dominicstange13/The-Infinite-Book/booklayout.jpeg

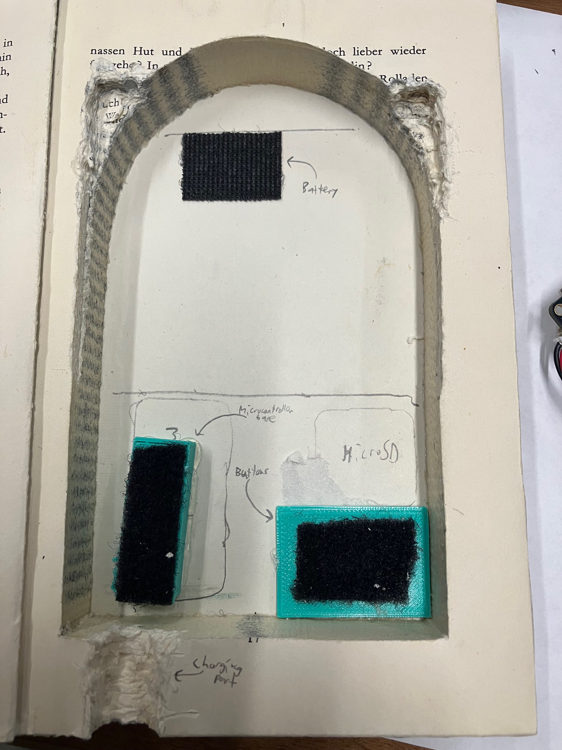
booklayout.jpeg
