dominicstange13/The-Infinite-Book/BOM.csv

Item Name | Qty | Price (total) (USD) | Item link | Notes
4.2" E-paper display | 1 | $24.95 | https://www.adafruit.com/product/6381
3.7v 500mAh LiPo Battery | 1 | $7.95 | https://www.adafruit.com/product/1578
Adafruit RP2040 Feather ThinkInk | 1 | $17.50 | https://www.adafruit.com/product/5727
Adafruit MicroSD SPI or SDIO Breakout Board | 1 | $3.50 | https://www.adafruit.com/product/4682
Copper Wire | 1 | $13.98 | https://www.amazon.com/BNTECHGO-Silicone-Flexible-Stranded-Impedance/dp/B01KCPKSEK?s=industrial | Literally almost any wire will work for this, don't worry!
2 pin push buttons | 3 | $7.49 | https://www.walmart.com/ip/44pcs-6x3-5x5mm-Round-Pushbutton-2-Pin-Momentary-DIP-Tactile-Switch/45588157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 | Only about 17 cents each
PLA filament | 1 | $14.97 | https://www.3djake.com/the-filament/pla-circuit-green | The cost of the parts themselves to print is basically nothing
Adhesive velcro strips | 1 | $2.49 | https://www.corpconnect.com/self-adhesive-velcro-strip-3 | The velcro goes on top of the microcontroller base, beneath the battery and beneath the buttons
MicroSD card (16gb) | 1 | $10.00 | https://www.walmart.com/ip/Team-16GB-microSDHC-UHS-I-U1-Class-10-Memory-Card-with-Adapter-Speed-Up-to-80MB-s-TUSDH16GCL10U03/5005423566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 | 16gb is honestly overkill, you can use less and you'll probably be fine as plain text takes up very little space
Book safe | 1 | $18.48 | https://www.etsy.com/listing/633148006/blue-hollow-book-safe-book-safe-hollowed?gpla=1&gao=1&=
1kohm resistors | 2 | $1.25 | https://www.sparkfun.com/resistor-1k-ohm-1-4-watt-pth-20-pack-thick-leads.html | Only a few cents each
Arduino libraries | N/A | N/A | N/A | SD, Adafruit BusIO, Adafruit EPD, Adafruit GFX Library, GxEPD2
Total Price (USD): | $122.56
