dominicstange13/The-Infinite-Book/CAD files/microcontroller base.step

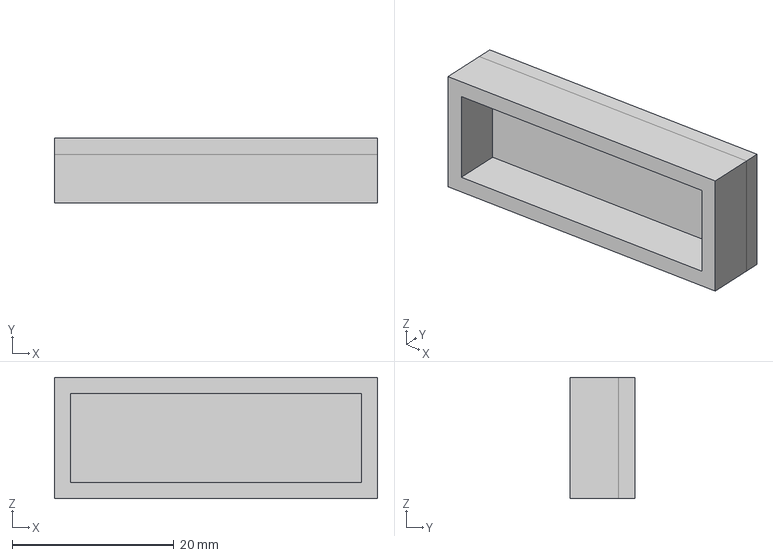
[picture p3: CAD file, 2026-10-19]
CAD files/microcontroller base.step
40.0 x 8.00 x 15.0 mm
