dominicstange13/The-Infinite-Book/CAD files/button rear.step

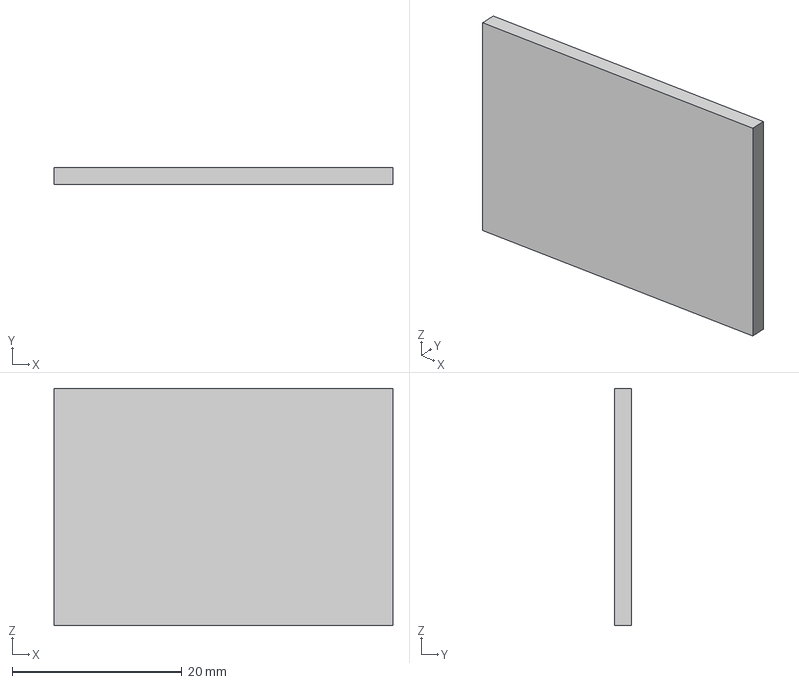
[picture p4: CAD file, 2026-10-19]
CAD files/button rear.step
40.0 x 2.00 x 28.0 mm
