dominicstange13/The-Infinite-Book/CAD files/button panel.step

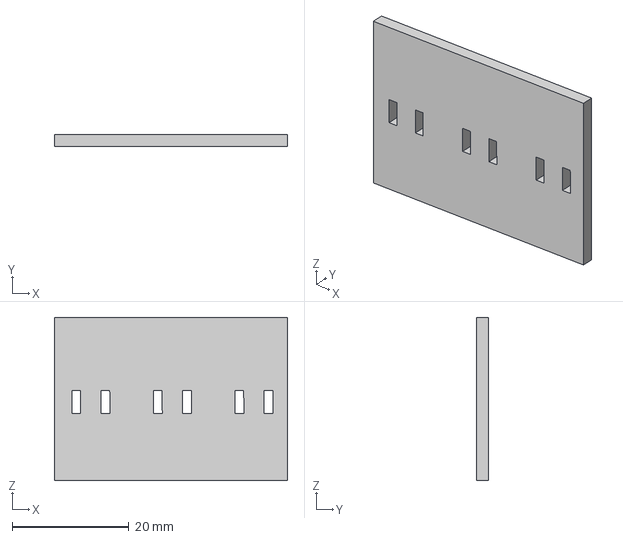
[picture p5: CAD file, 2026-10-19]
CAD files/button panel.step
40.0 x 2.00 x 28.0 mm
