dominicstange13/The-Infinite-Book/wiring/wiring1.jpeg

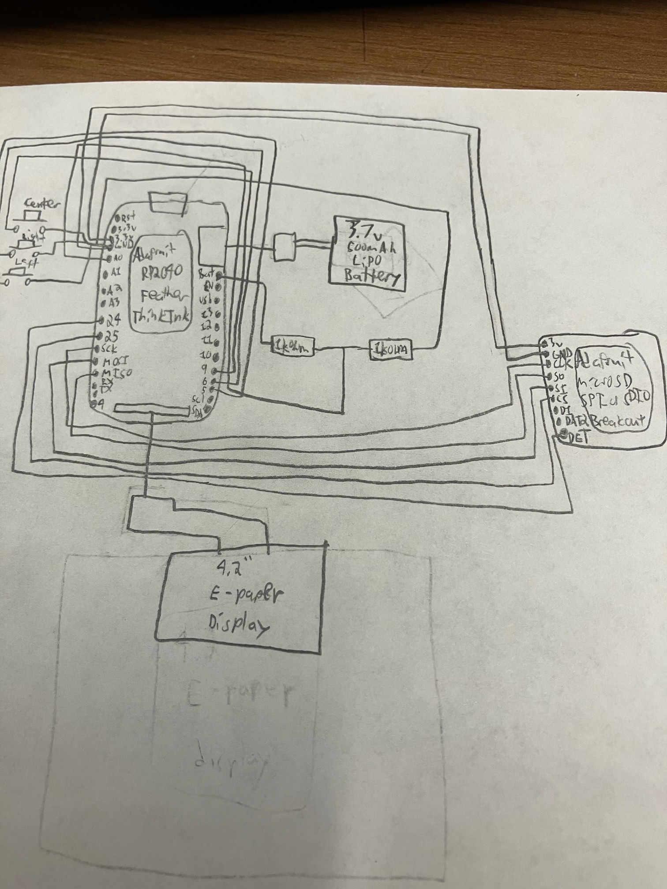
wiring/wiring1.jpeg
