dominicstange13/The-Infinite-Book/wiring/wiring2.jpeg

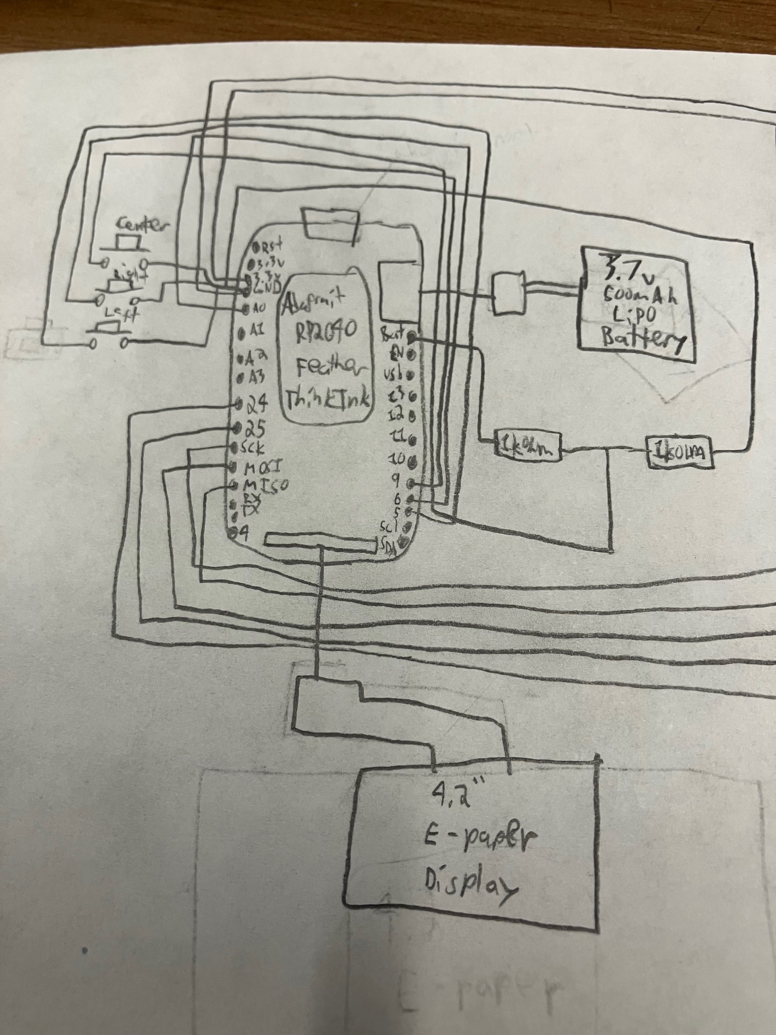
wiring/wiring2.jpeg
