dominicstange13/The-Infinite-Book/wiring/wiring3.jpeg

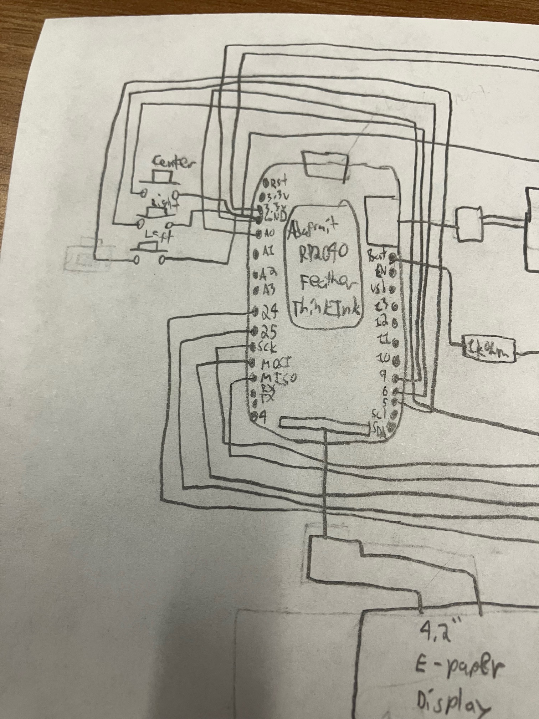
wiring/wiring3.jpeg
