dominicstange13/The-Infinite-Book/wiring/wiring4.jpeg

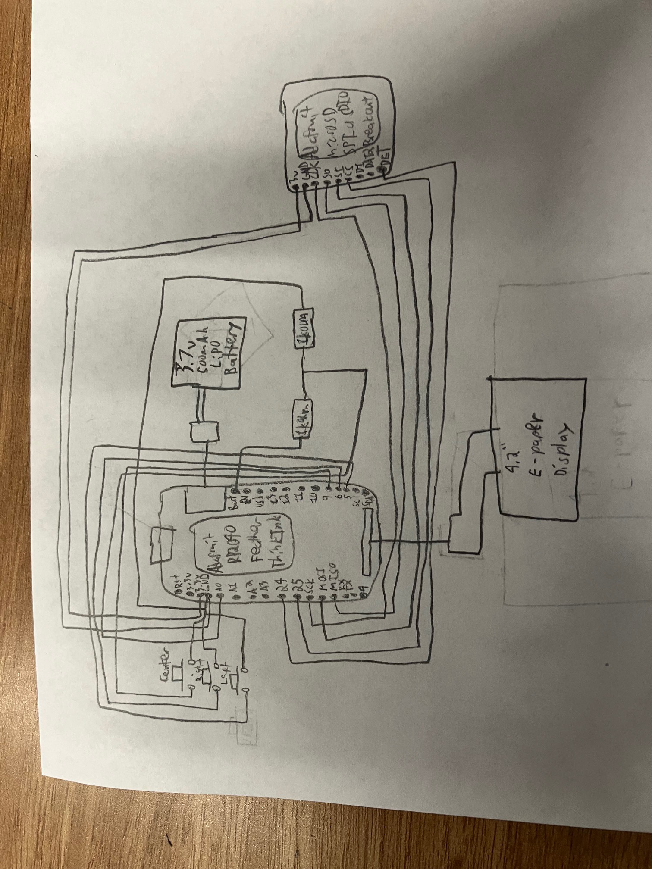
wiring/wiring4.jpeg
