dominicstange13/The-Infinite-Book/wiring/wiring5.jpeg

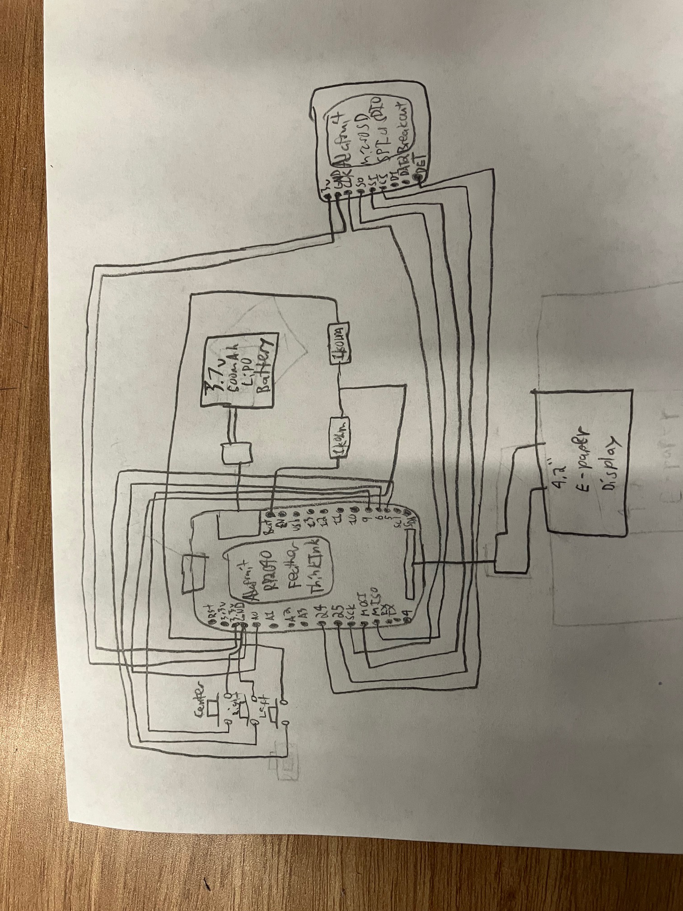
wiring/wiring5.jpeg
